deng-weihong/binbot/01_3D_MD_ME_Binbot/README.md

# BinBot 3D 与机械设计资料

**当前结构仅适用于 3D 打印，未做拔模设计，不可直接用于开模注塑。**

| 目录 | 内容 | 当前资料 |
| --- | --- | --- |
| [MD](MD/README.md) | 机械结构设计（Mechanical Design） | 结构总装、子装配、壳体、支架与垫片的 STEP 模型，共 23 个文件 |

机械结构资料的打开入口为
[`MD/step/binbot_master_asm_top.stp`](MD/step/binbot_master_asm_top.stp)。
请下载整个 `MD/step/` 目录，保留其中所有模型的原始文件名和相对位置。

PCB、原理图、BOM 和板级说明归入 [硬件资料目录](../03_Hardware_Binbot/)。
