deng-weihong/binbot/01_3D_MD_ME_Binbot/MD/step/camera_fix_prt.stp

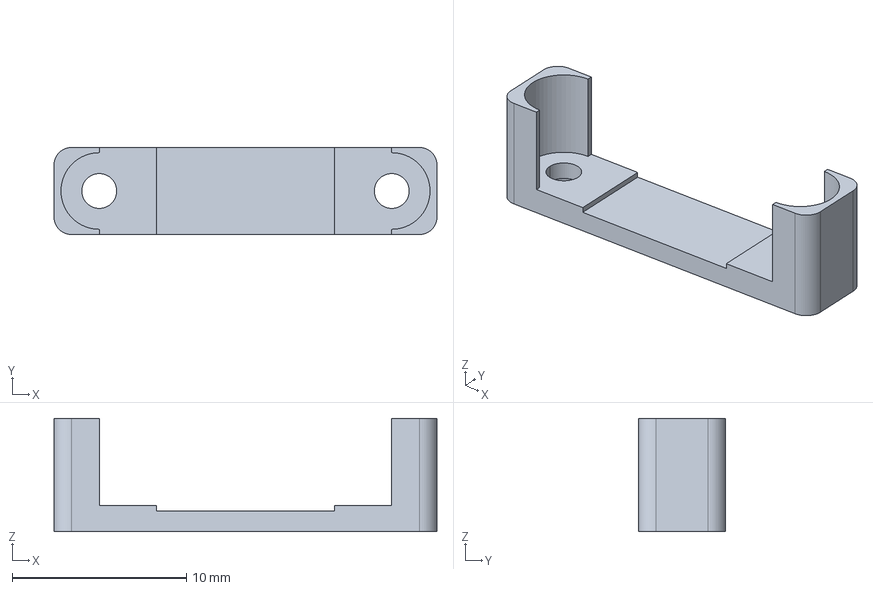
[picture p9: CAD file, 2026-11-06]
01_3D_MD_ME_Binbot/MD/step/camera_fix_prt.stp
22.0 x 5.00 x 6.50 mm
