deng-weihong/binbot/01_3D_MD_ME_Binbot/MD/step/speaker_shell_prt.stp

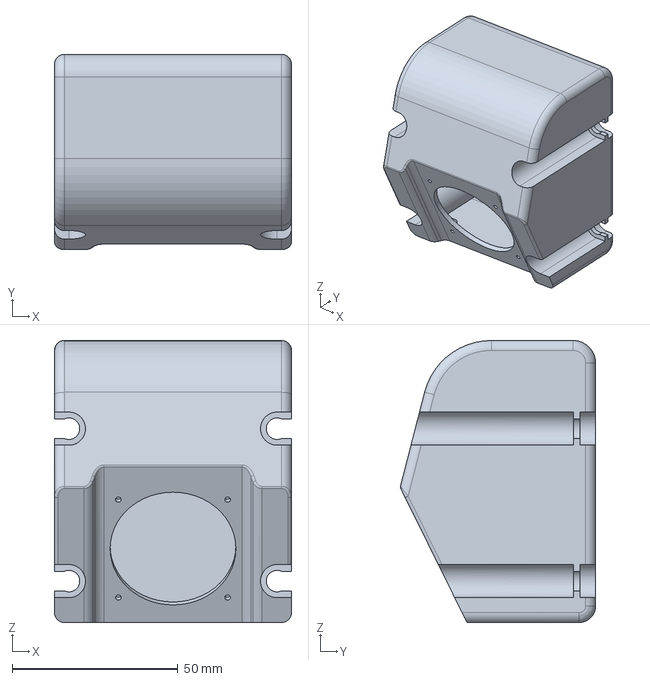
[picture p10: CAD file, 2026-11-06]
01_3D_MD_ME_Binbot/MD/step/speaker_shell_prt.stp
71.6 x 59.0 x 85.2 mm
