deng-weihong/binbot/01_3D_MD_ME_Binbot/MD/step/rubber_pad_44_12_2_prt.stp

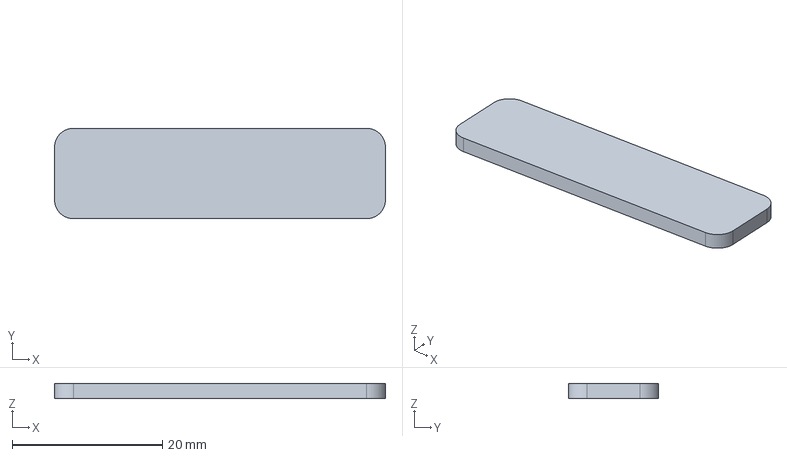
[picture p11: CAD file, 2026-11-06]
01_3D_MD_ME_Binbot/MD/step/rubber_pad_44_12_2_prt.stp
44.0 x 12.0 x 2.00 mm
