deng-weihong/binbot/01_3D_MD_ME_Binbot/MD/step/key_fix_prt.stp

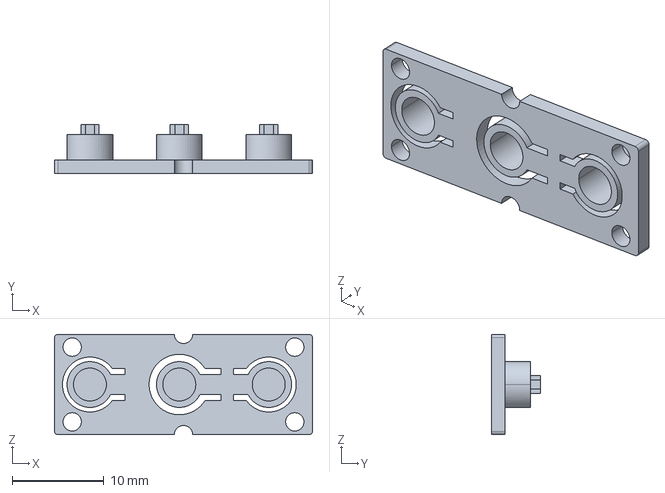
[picture p12: CAD file, 2026-11-06]
01_3D_MD_ME_Binbot/MD/step/key_fix_prt.stp
28.2 x 5.40 x 11.0 mm
