deng-weihong/binbot/01_3D_MD_ME_Binbot/MD/step/rear_cover_prt.stp

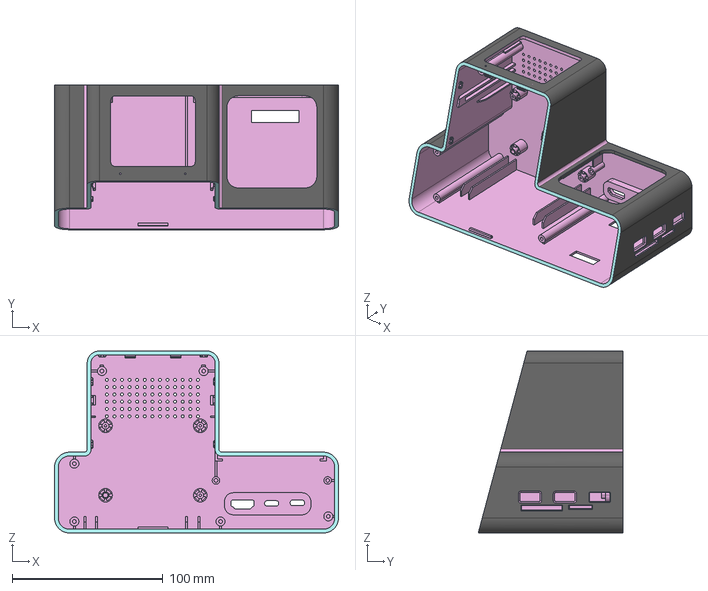
[picture p13: CAD file, 2026-11-06]
01_3D_MD_ME_Binbot/MD/step/rear_cover_prt.stp
188.4 x 95.9 x 120.7 mm
