deng-weihong/binbot/01_3D_MD_ME_Binbot/MD/step/front_ctrl_key_small__prt.stp

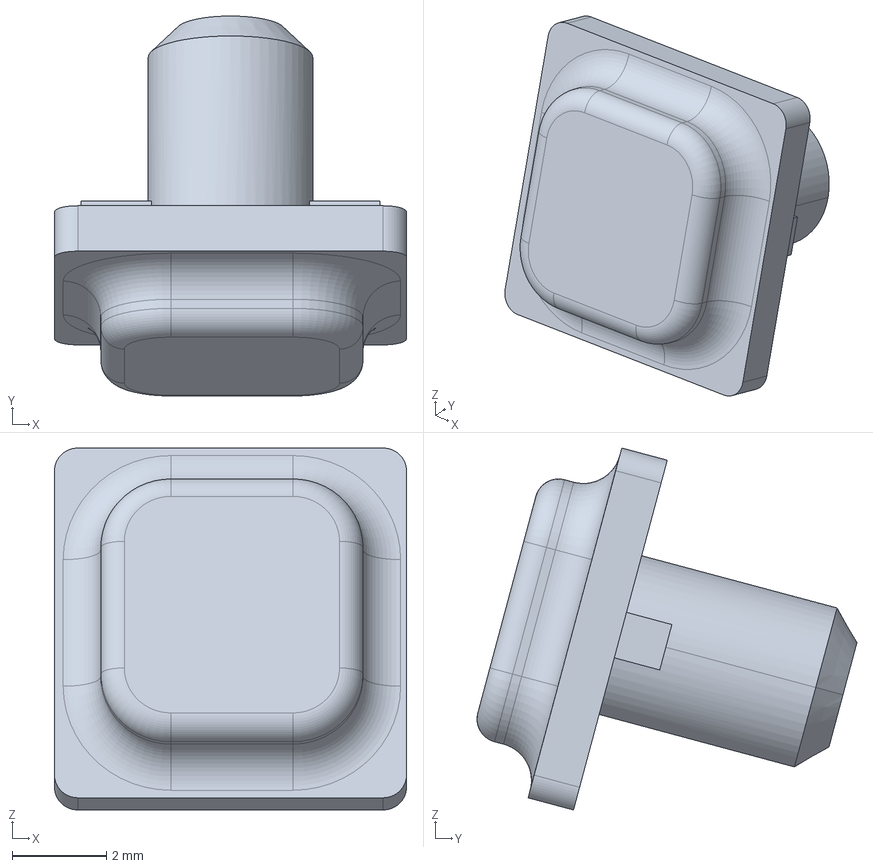
[picture p14: CAD file, 2026-11-06]
01_3D_MD_ME_Binbot/MD/step/front_ctrl_key_small__prt.stp
7.48 x 8.08 x 7.70 mm
