deng-weihong/binbot/01_3D_MD_ME_Binbot/MD/step/front_ctrl_board_part__prt.stp

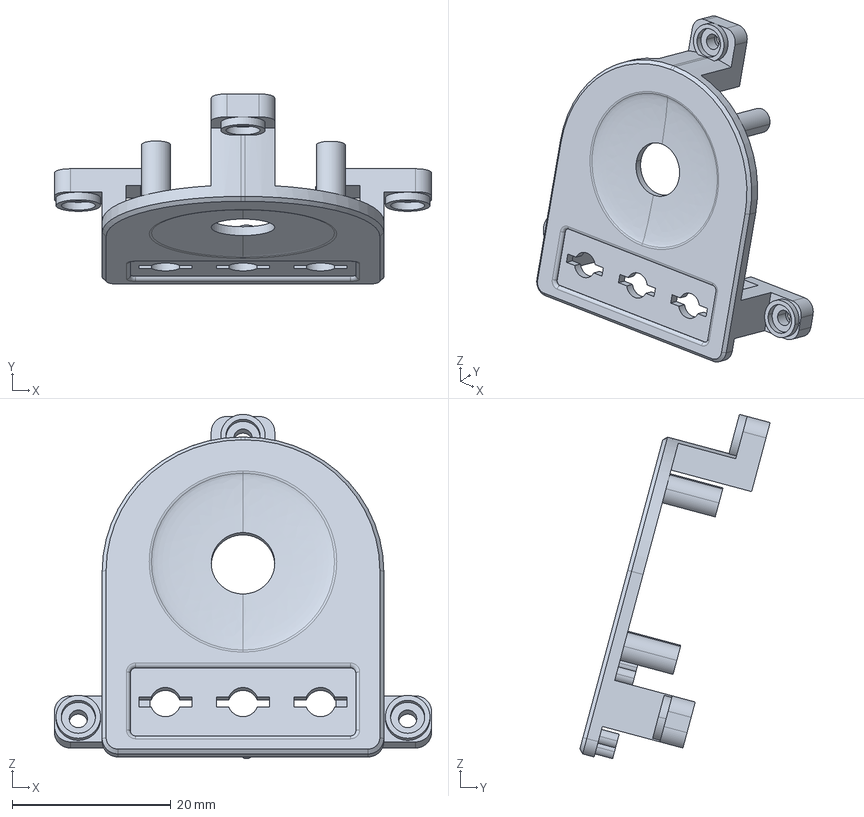
[picture p15: CAD file, 2026-11-06]
01_3D_MD_ME_Binbot/MD/step/front_ctrl_board_part__prt.stp
47.5 x 24.0 x 43.3 mm
