deng-weihong/binbot/01_3D_MD_ME_Binbot/MD/step/front_ctrl_knob__prt.stp

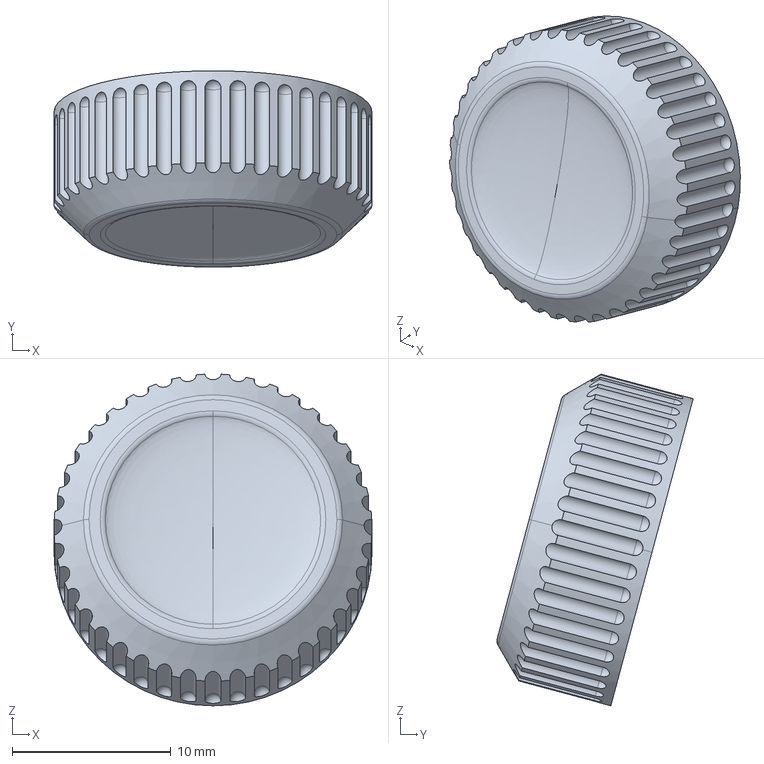
[picture p16: CAD file, 2026-11-06]
01_3D_MD_ME_Binbot/MD/step/front_ctrl_knob__prt.stp
20.0 x 12.3 x 20.9 mm
