deng-weihong/binbot/01_3D_MD_ME_Binbot/MD/step/module_slot_prt.stp

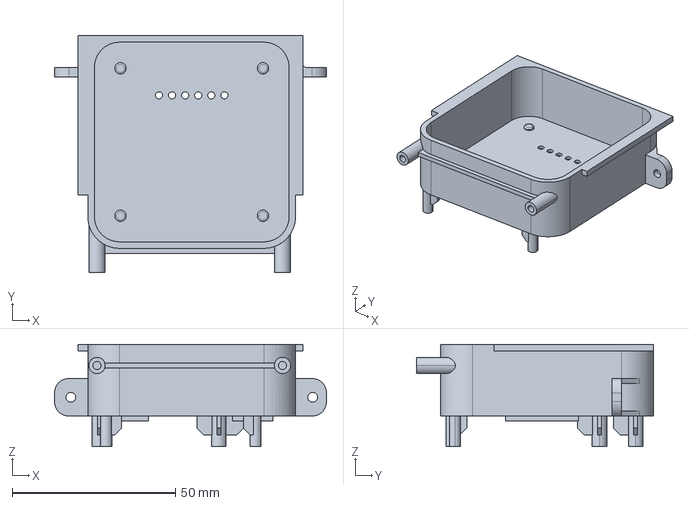
[picture p17: CAD file, 2026-11-06]
01_3D_MD_ME_Binbot/MD/step/module_slot_prt.stp
83.4 x 72.5 x 31.4 mm
