deng-weihong/binbot/01_3D_MD_ME_Binbot/MD/step/acoutsti_cover_prt.stp

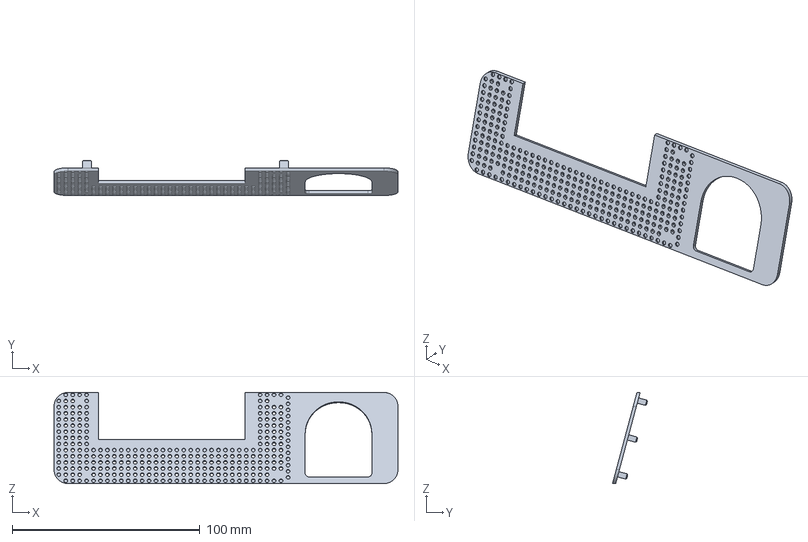
[picture p18: CAD file, 2026-11-06]
01_3D_MD_ME_Binbot/MD/step/acoutsti_cover_prt.stp
183.3 x 18.6 x 48.5 mm
