deng-weihong/binbot/01_3D_MD_ME_Binbot/MD/step/top_wireless_charge_prt.stp

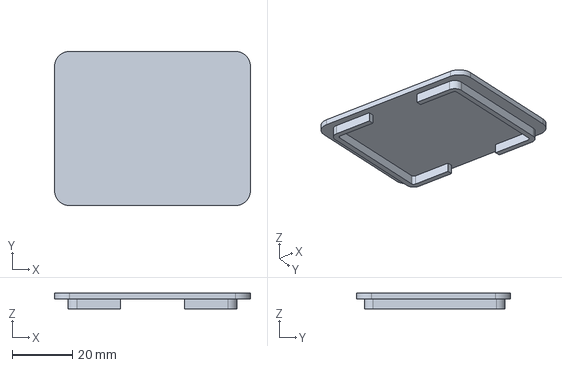
[picture p19: CAD file, 2026-11-06]
01_3D_MD_ME_Binbot/MD/step/top_wireless_charge_prt.stp
65.0 x 51.2 x 5.30 mm
