deng-weihong/binbot/01_3D_MD_ME_Binbot/MD/step/wireless_charge_pcba_fix_prt.stp

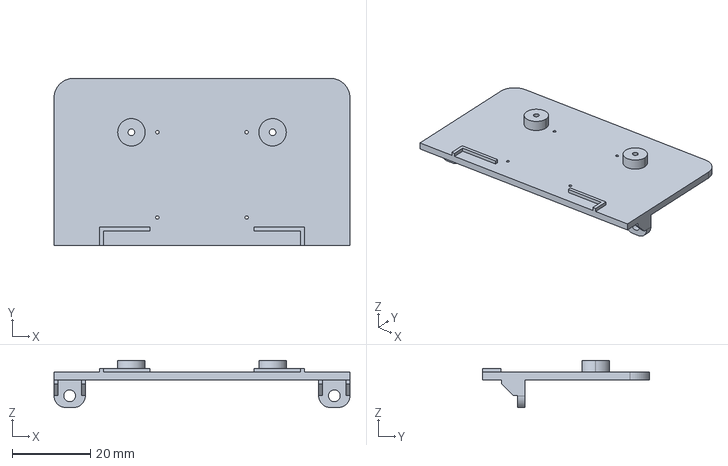
[picture p20: CAD file, 2026-11-06]
01_3D_MD_ME_Binbot/MD/step/wireless_charge_pcba_fix_prt.stp
75.5 x 42.7 x 12.0 mm
