deng-weihong/binbot/01_3D_MD_ME_Binbot/MD/step/acousti_fix_cover_prt.stp

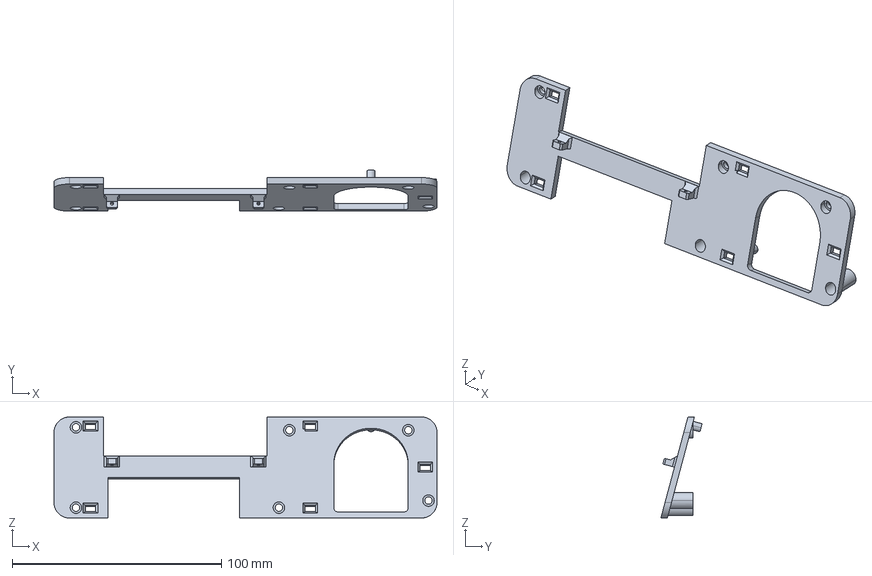
[picture p21: CAD file, 2026-11-06]
01_3D_MD_ME_Binbot/MD/step/acousti_fix_cover_prt.stp
183.0 x 19.7 x 48.2 mm
