deng-weihong/binbot/01_3D_MD_ME_Binbot/MD/step/front_cover_prt.stp

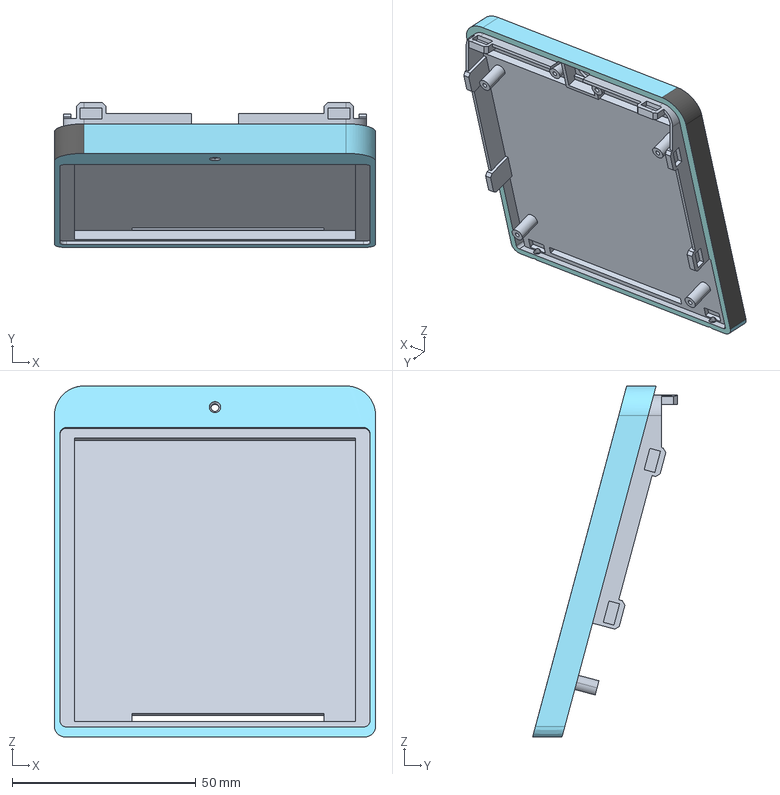
[picture p22: CAD file, 2026-11-06]
01_3D_MD_ME_Binbot/MD/step/front_cover_prt.stp
87.4 x 39.4 x 95.5 mm
