deng-weihong/binbot/01_3D_MD_ME_Binbot/MD/step/wireless_charge_coil_fix_prt.stp

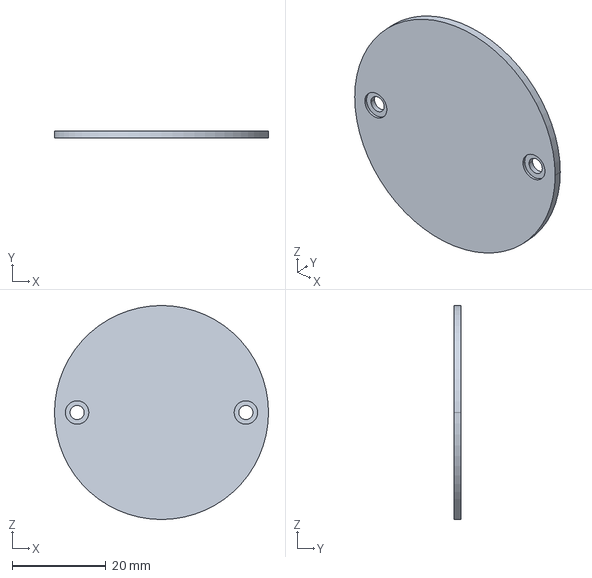
[picture p23: CAD file, 2026-11-06]
01_3D_MD_ME_Binbot/MD/step/wireless_charge_coil_fix_prt.stp
45.6 x 1.50 x 45.6 mm
