deng-weihong/binbot/01_3D_MD_ME_Binbot/MD/step/front_ctrl_key_big__prt.stp

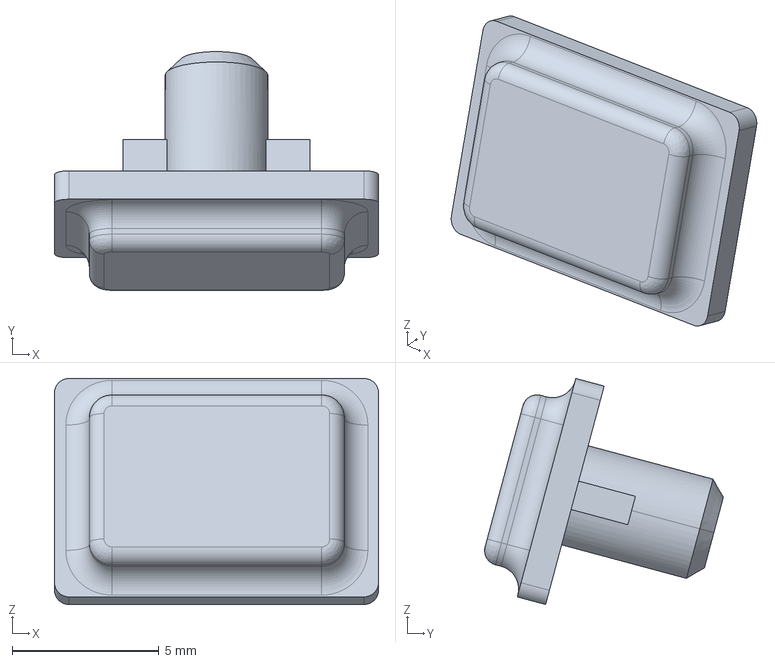
[picture p24: CAD file, 2026-11-06]
01_3D_MD_ME_Binbot/MD/step/front_ctrl_key_big__prt.stp
11.0 x 8.13 x 7.70 mm
