deng-weihong/binbot/(list of files, cad)

Other CAD files:
01_3D_MD_ME_Binbot/MD/step/binbot_shell_asm_asm.stp
01_3D_MD_ME_Binbot/MD/step/binbot_master_asm_top.stp
01_3D_MD_ME_Binbot/MD/step/speaker_asm_asm.stp
01_3D_MD_ME_Binbot/MD/step/speaker_unit_asm_asm.stp
01_3D_MD_ME_Binbot/MD/step/binbot_ee_system_asm.stp
01_3D_MD_ME_Binbot/MD/step/soundhole_shell_as_asm.stp
01_3D_MD_ME_Binbot/MD/step/rubber_mat_prt.stp
