deng-weihong/binbot/03_Hardware_Binbot/RV1106G3_Main_Release_V1.0.pdf

# Index：

# P01 VERSION HISTORY

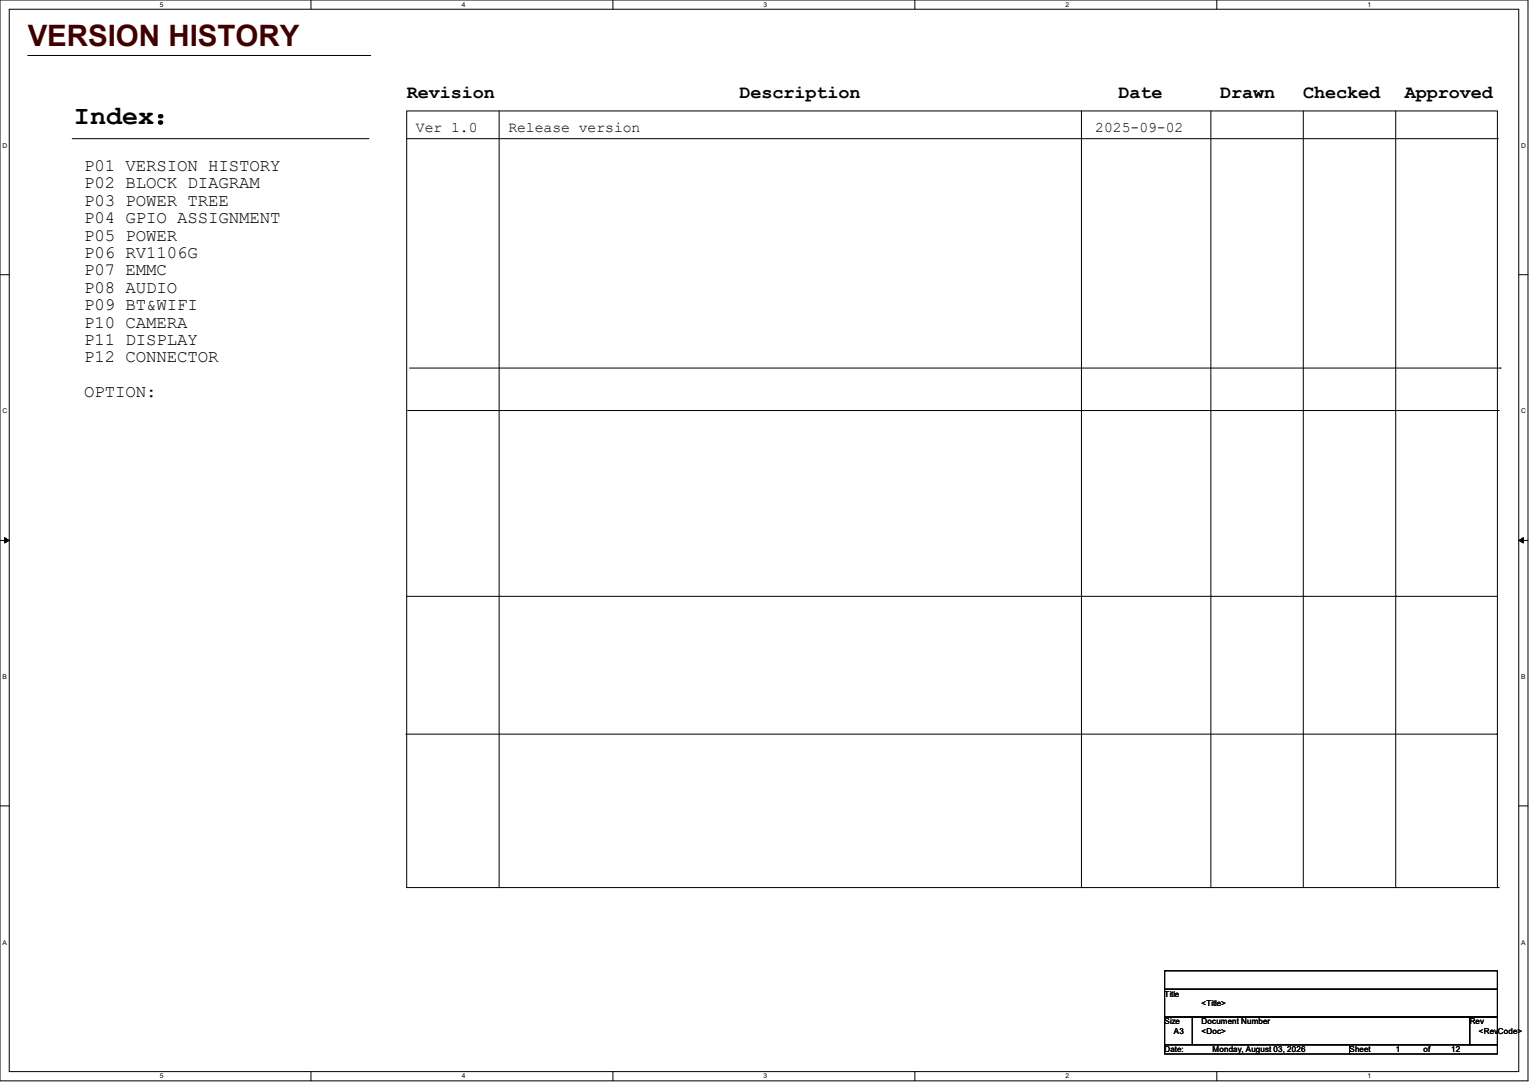
[picture p25: page 1]

# BLOCK

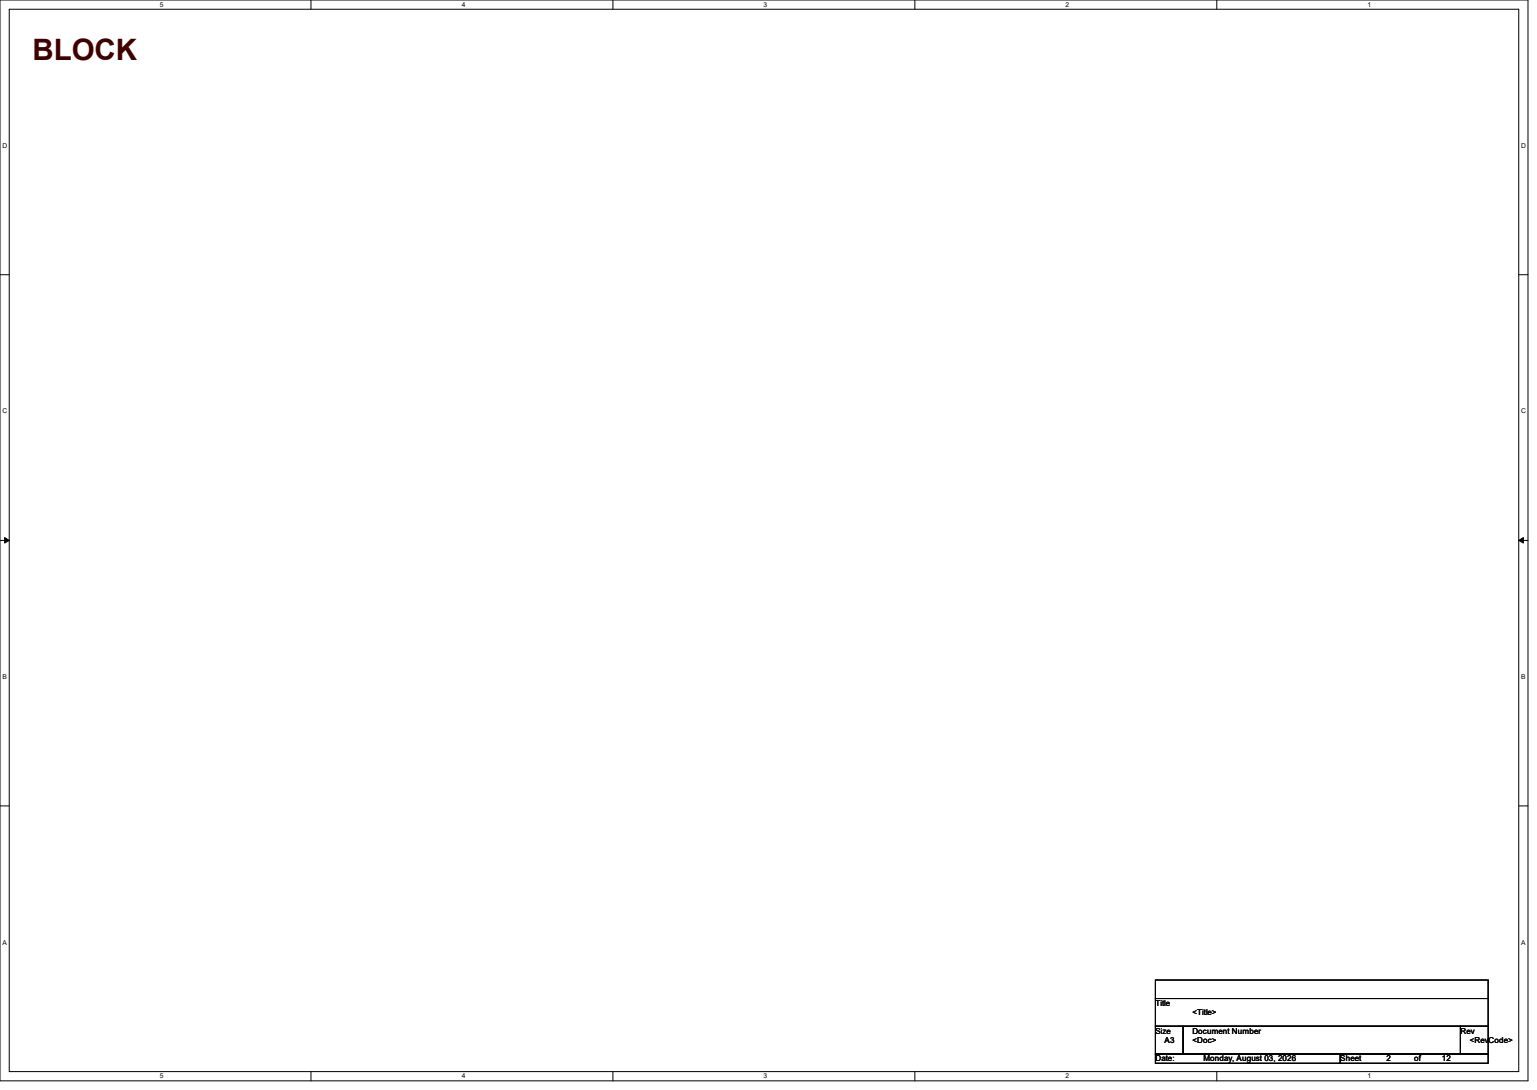
[picture p26: page 2]
Title; Monday, August 03, 2026

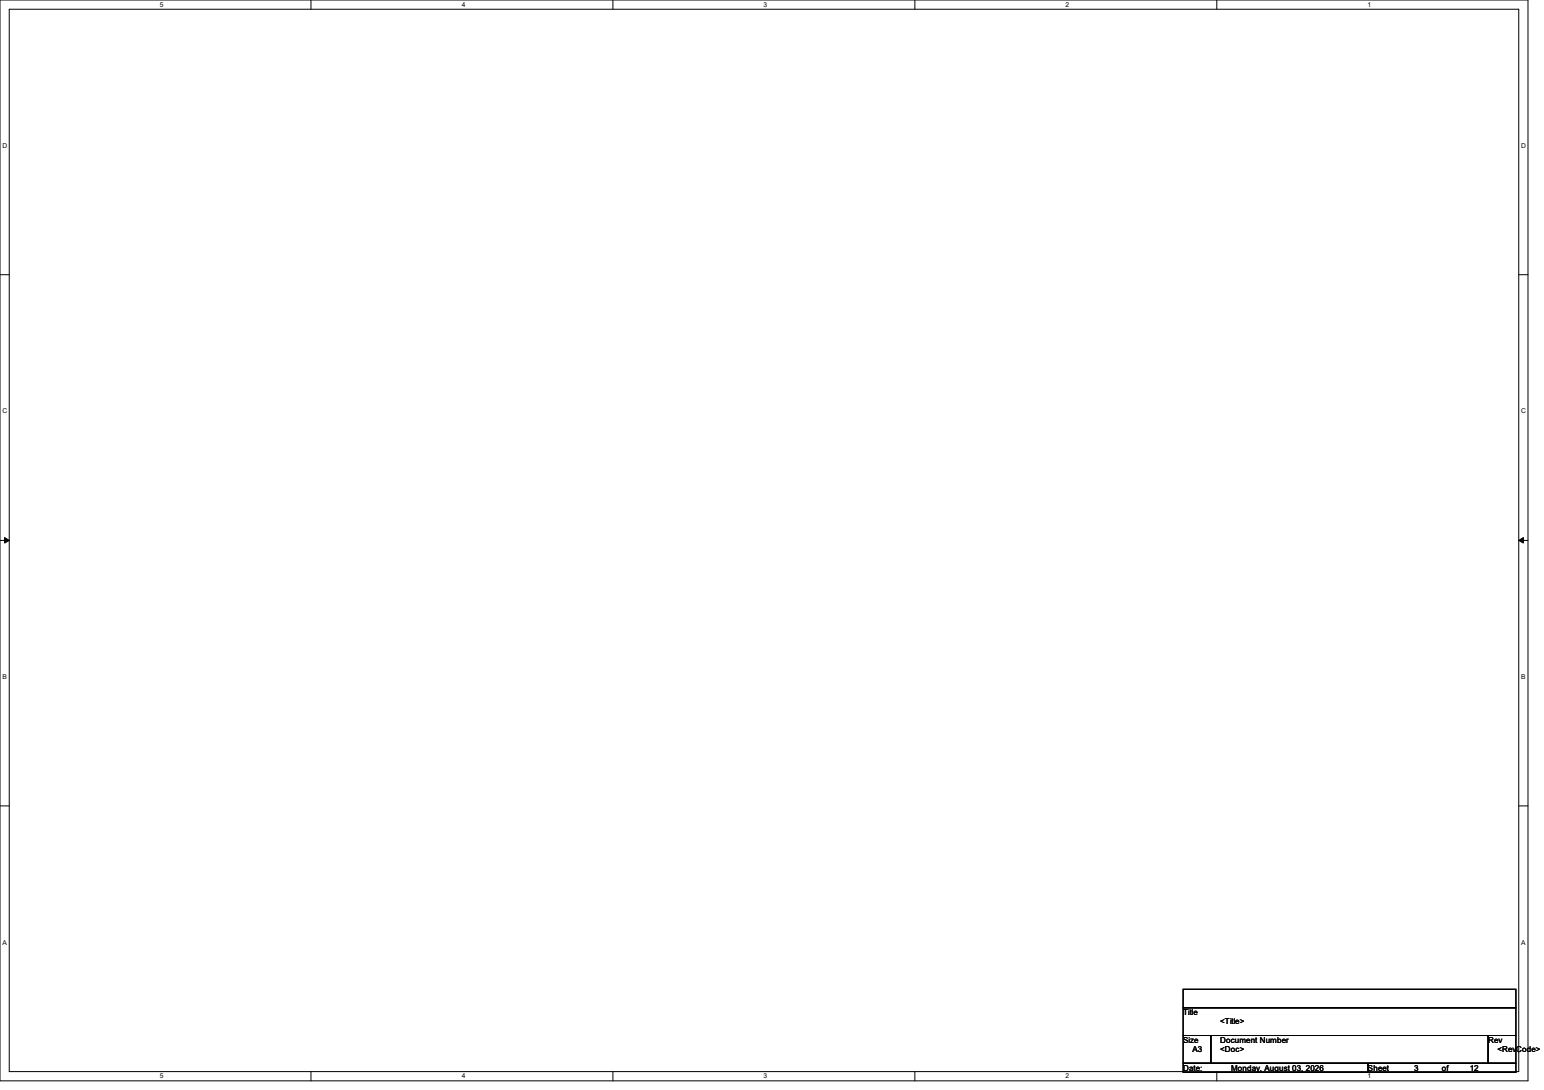
[picture p27: page 3]
Monday, August 03, 2026

# GPIO ASSIGNMENT

PIN | Define | CFG | Function

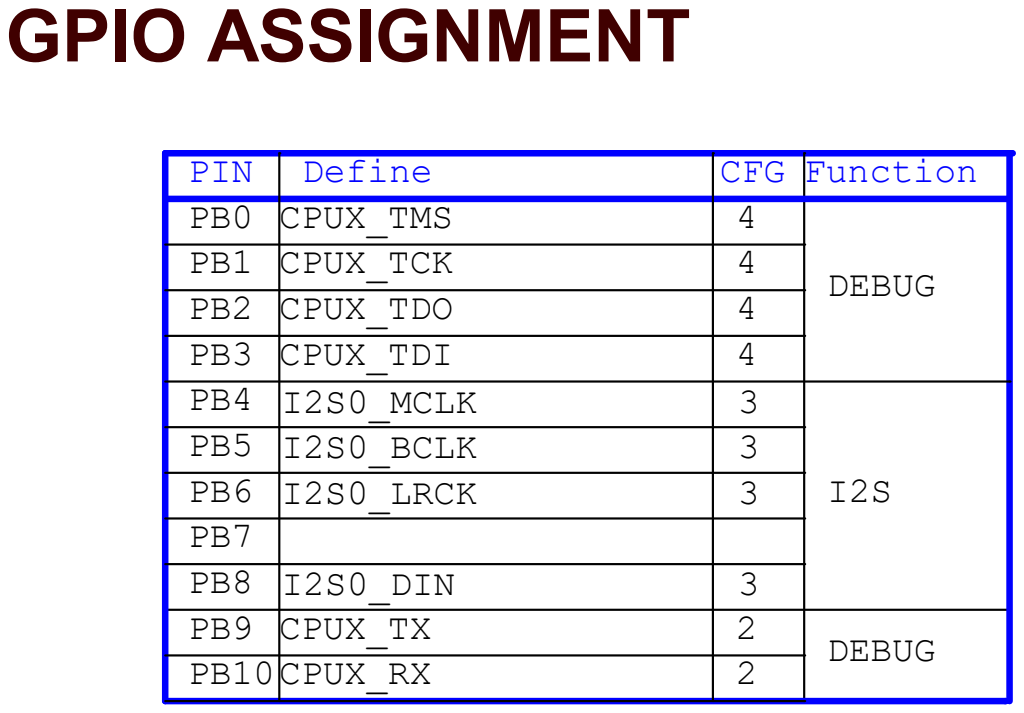
[picture p28: page 4]
DEBUG; CPUX_RX; CPUX_TX; Monday, August 03, 2026

PB0 | CPUX_TMS | 4 | DEBUG
PB1 | CPUX_TCK | 4
PB2 | CPUX_TDO | 4
PB3 | CPUX_TDI | 4
PB4 | I2S0_MCLK | 3 | I2S
PB5 | I2S0_BCLK | 3
PB6 | I2S0_LRCK | 3
PB7
PB8 | I2S0_DIN | 3

VCC-1V8 | VCC-OSC
VCC-3V3 | VCC-RTC

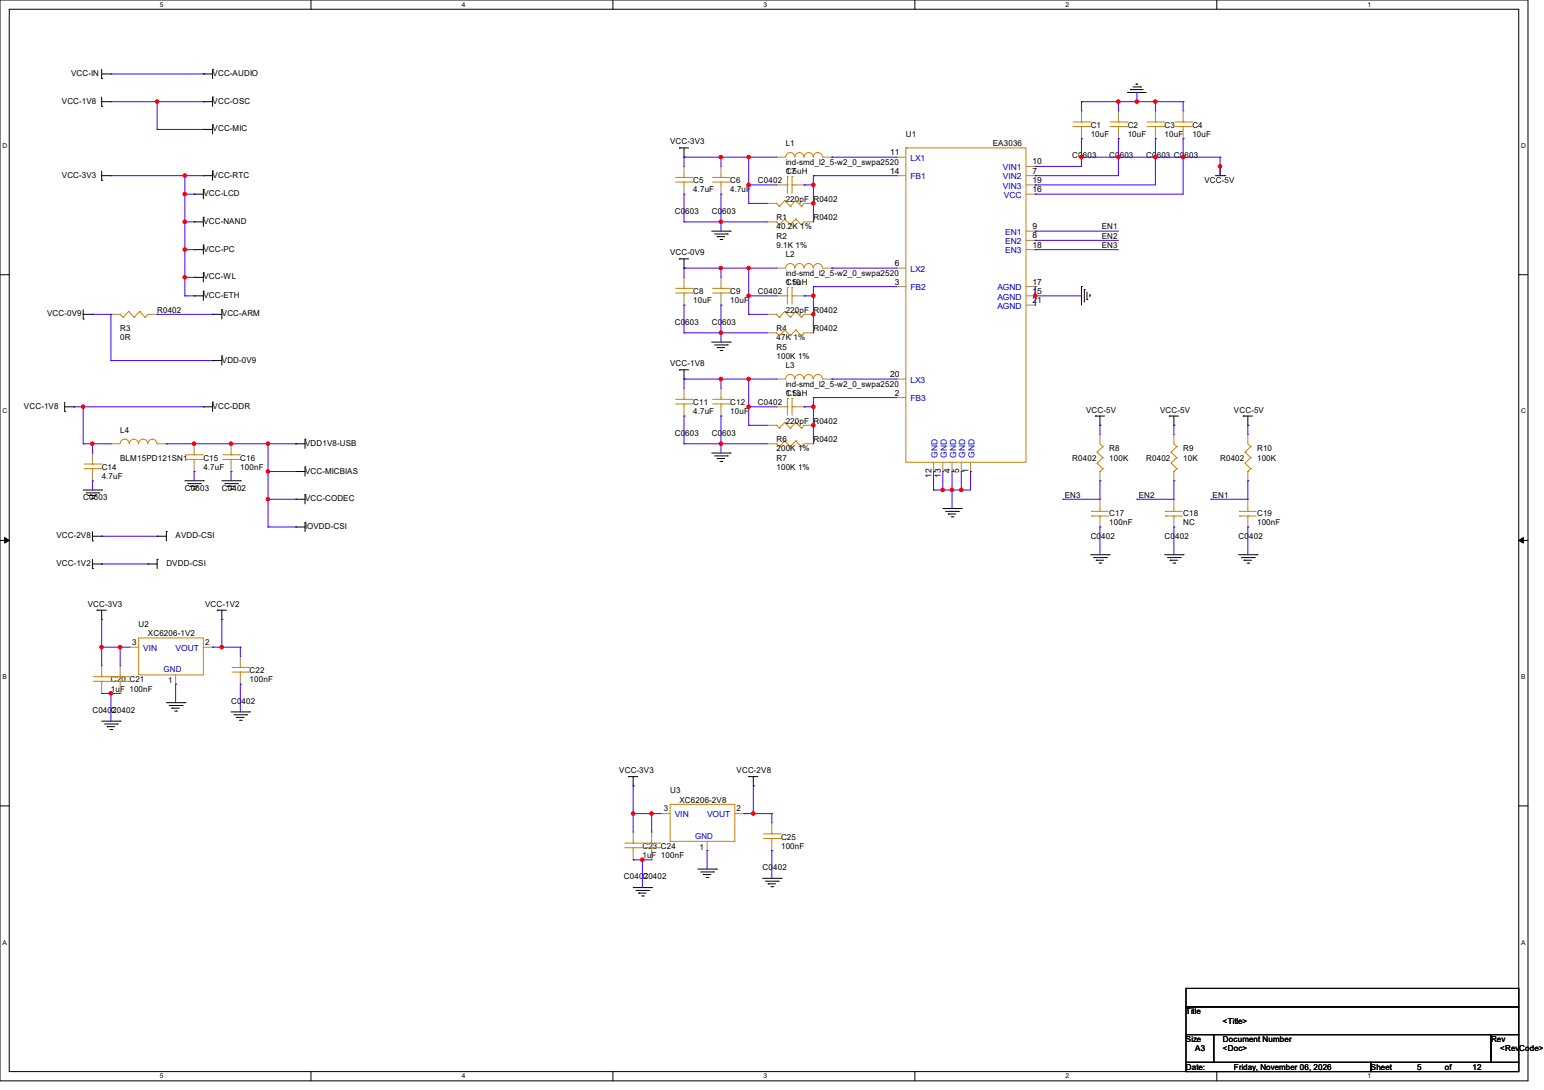
[picture p29: page 5]

# OSC/PLL/OTP

# RTC

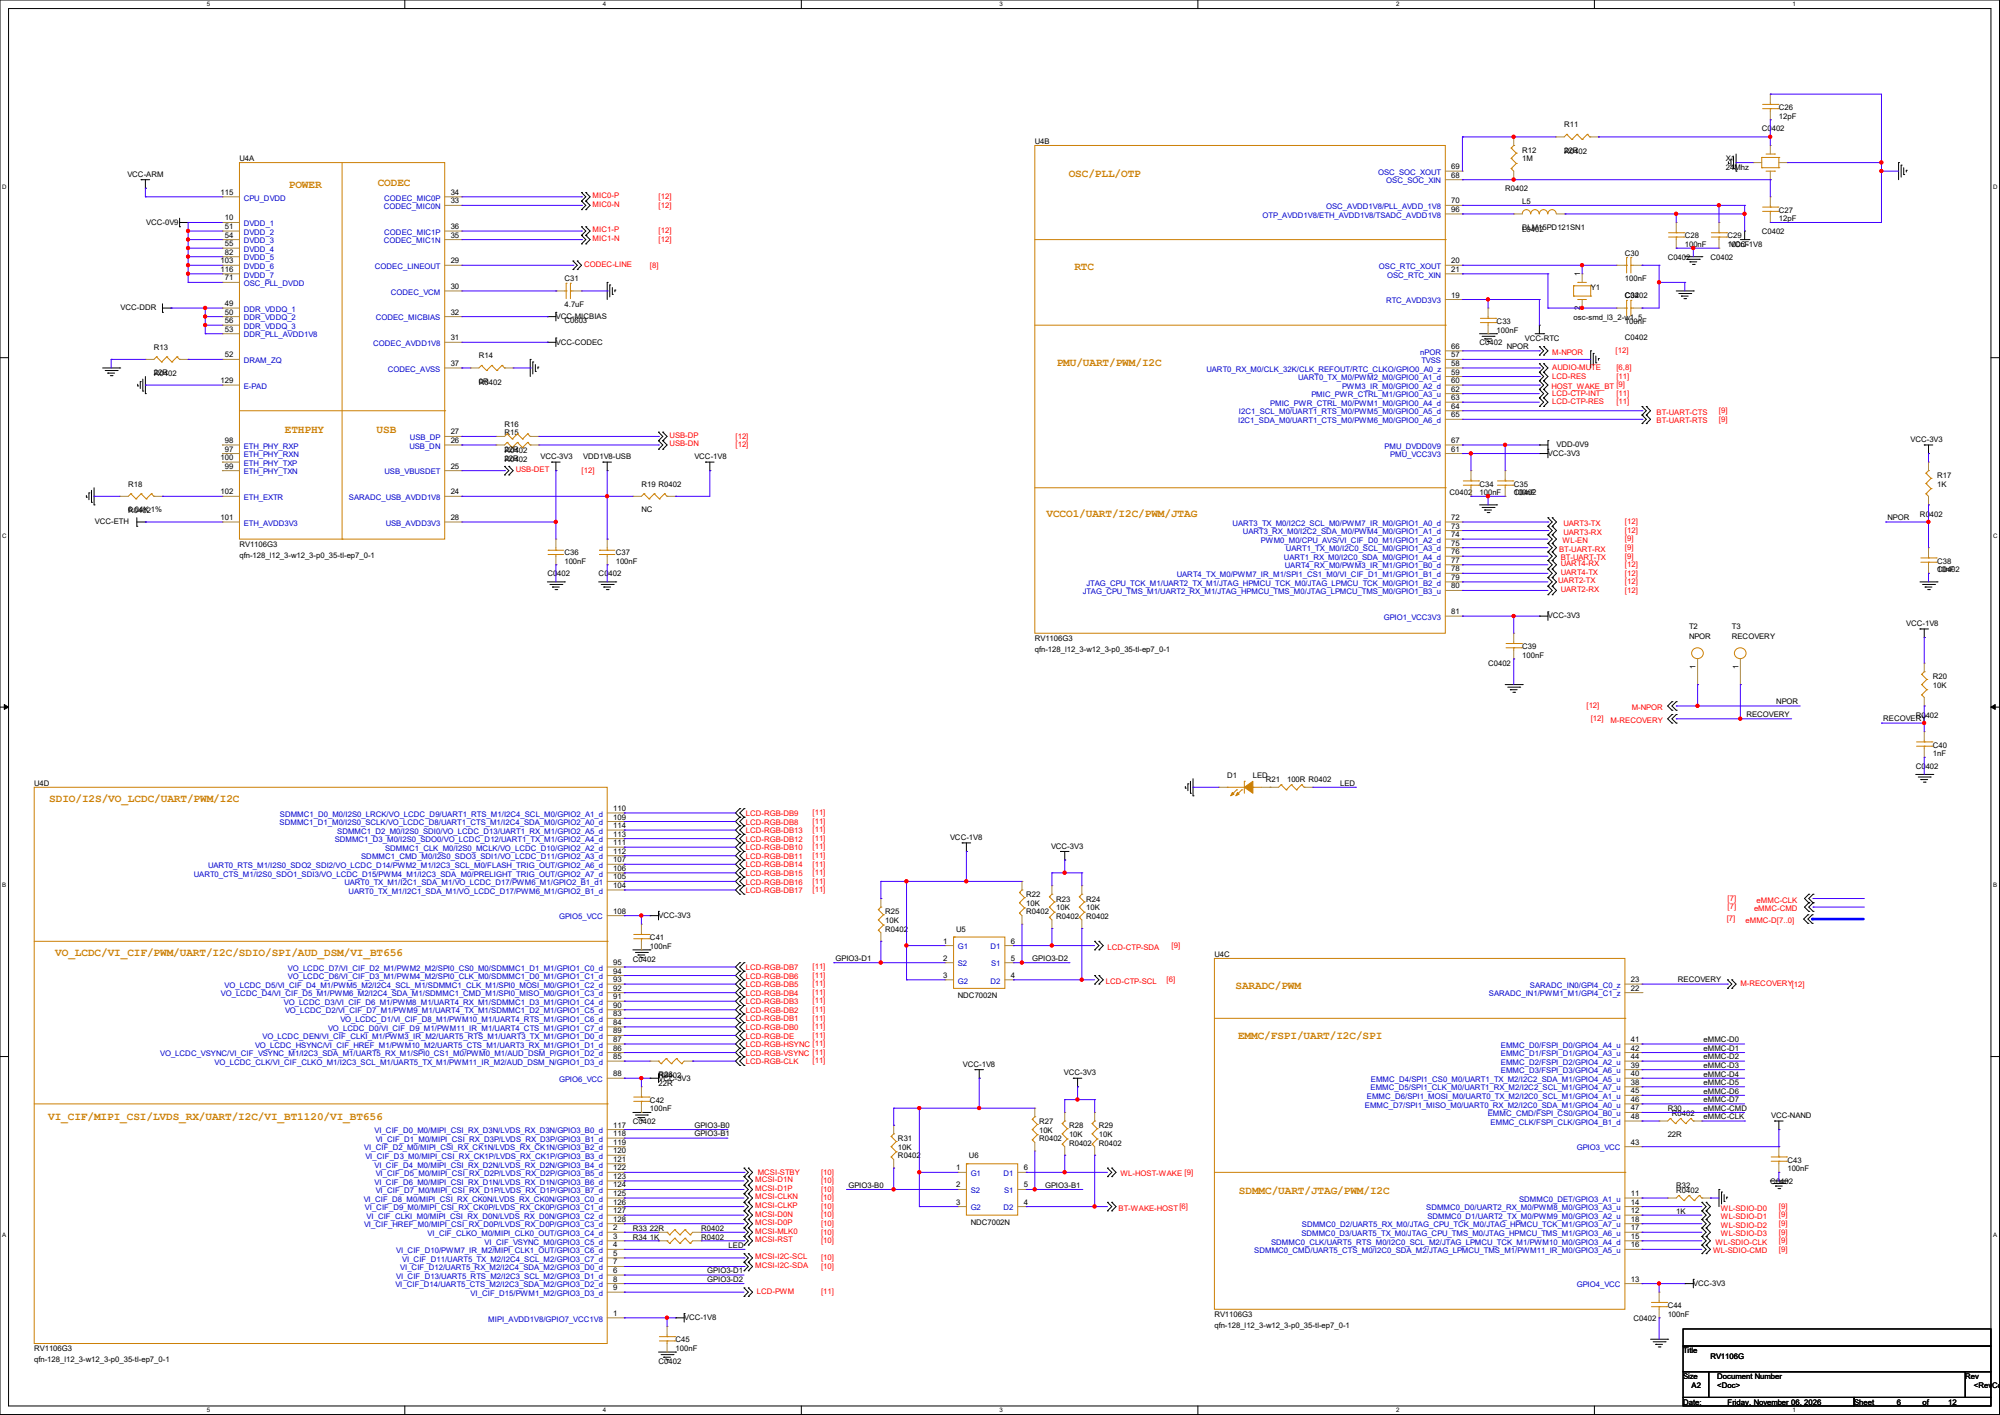
[picture p30: page 6]

VO_LCDC/VI_CIF/PWM/UART/I2C/SDIO/SPI/AUD_DSM/VI_BT656

EMMC/FSPI/UART/I2C/SPI

NDC7002N | 47 R30 eMMC-CMD 48 eMMC-CLK

SDMMC/UART/JTAG/PWM/I2C

E

M

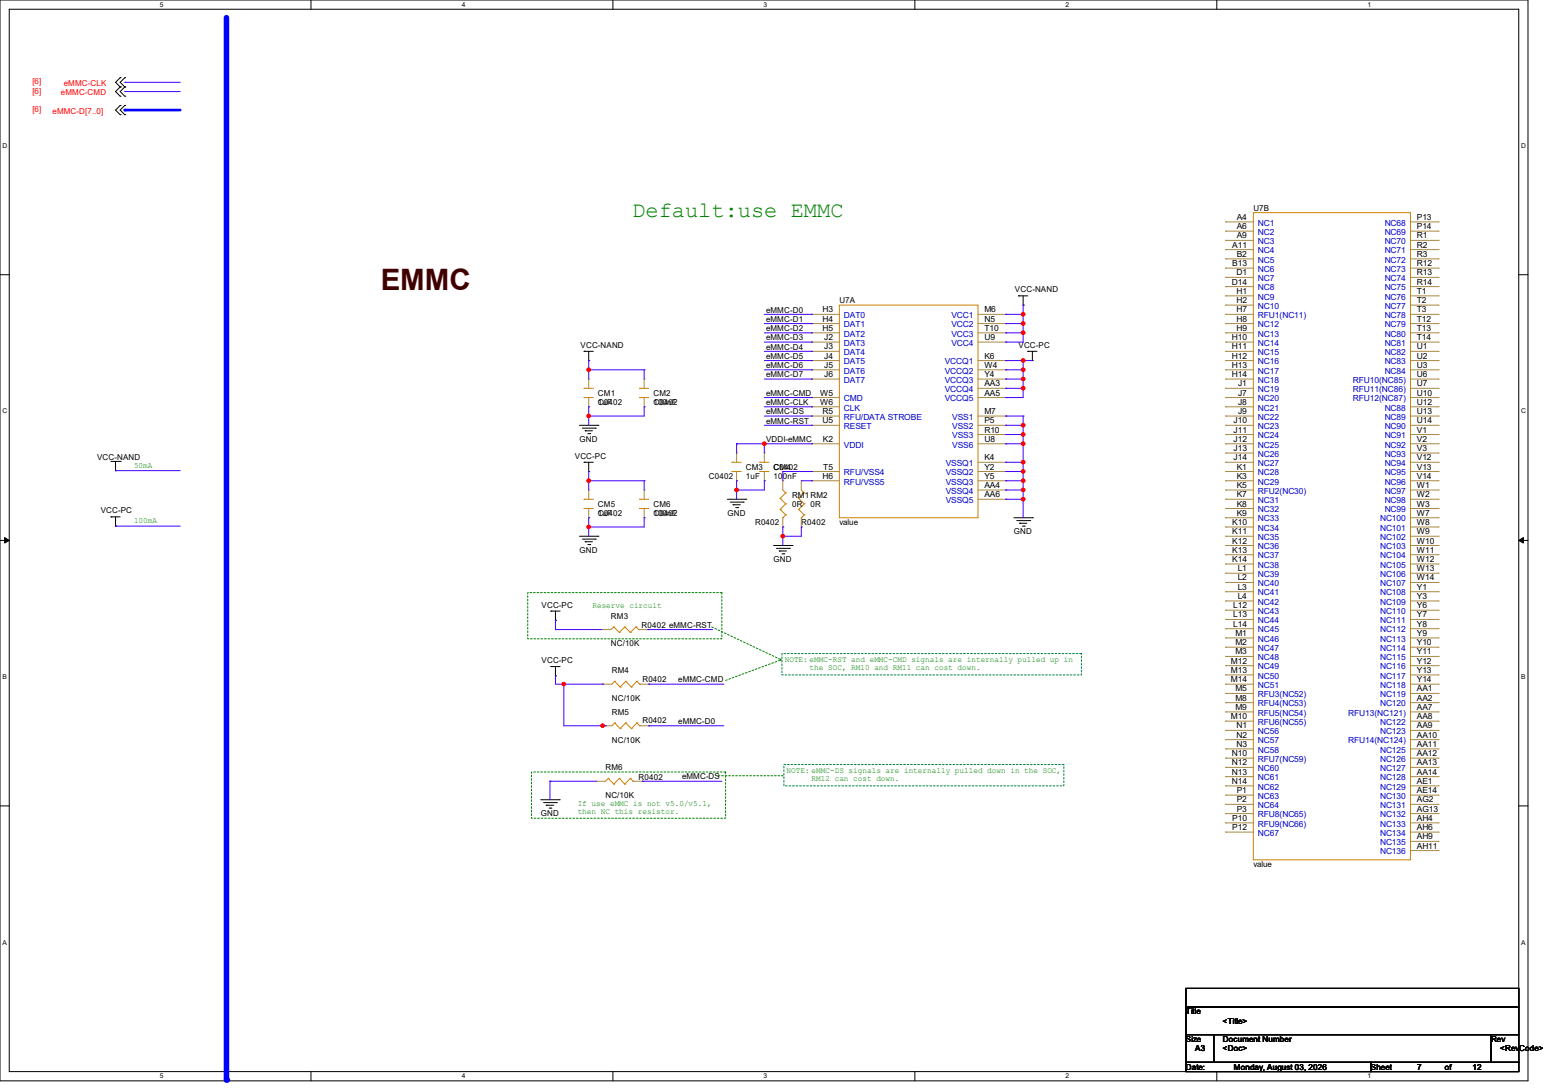
[picture p31: page 7]
Title Size; alu

D | D

# [6] CODEC-LINE

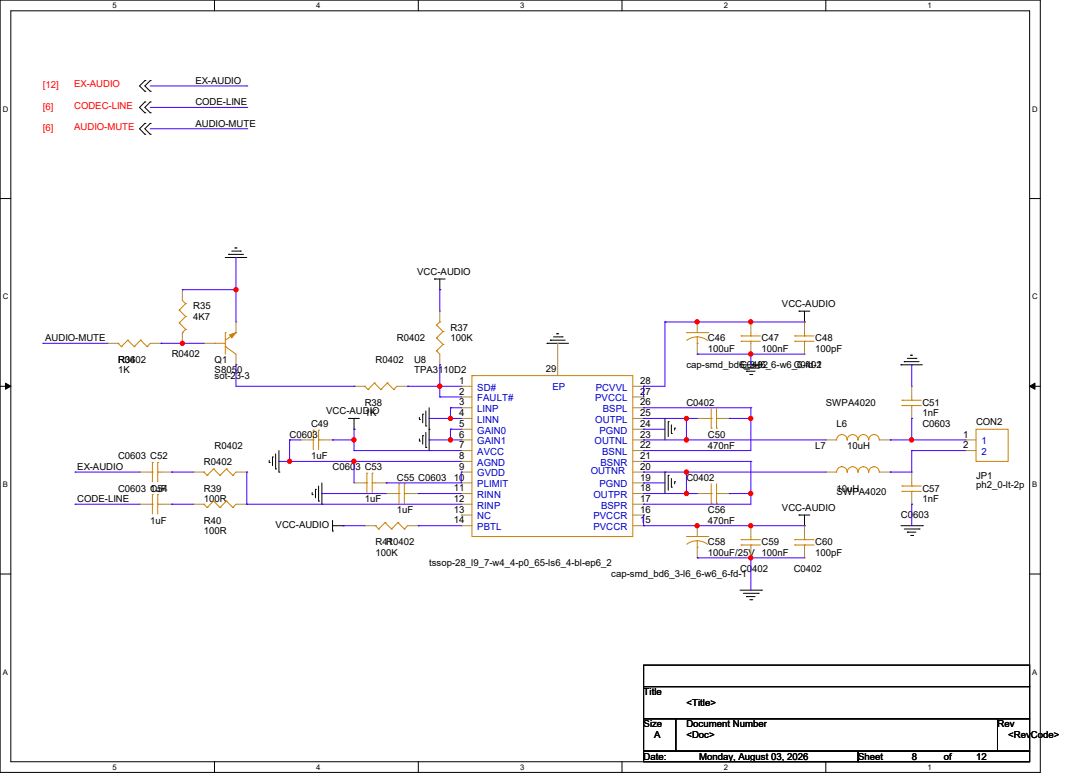
[picture p32: page 8]

55

44

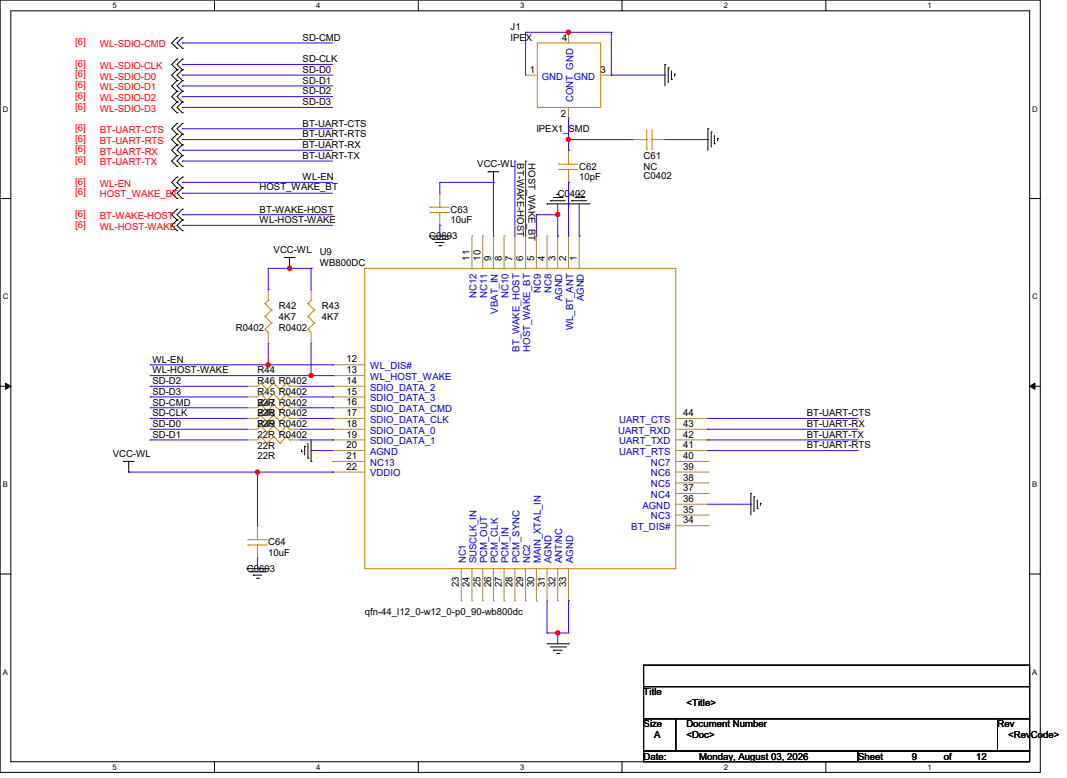
[picture p33: page 9]
DIO; Title Size; Title; GND 4 CONT 2; cBT_WAKE_HOST 7; DIS; HOST_WAKE_BT 6; AGND 1; AGND 3; AGND 31; AGND 33; ANT/NC 32; SUSCLK_IN 24; PCM_CLK 26 PCM_IN 27; PCM_OUT 25; PCM_SYNC 28; MAIN_XTAL_IN 30; VBAT_IN 9; WL_BT_ANT 2; HOST_WAKE_BT

BT-WAKE-HOST

D | D

# [6] MCSI-D1N

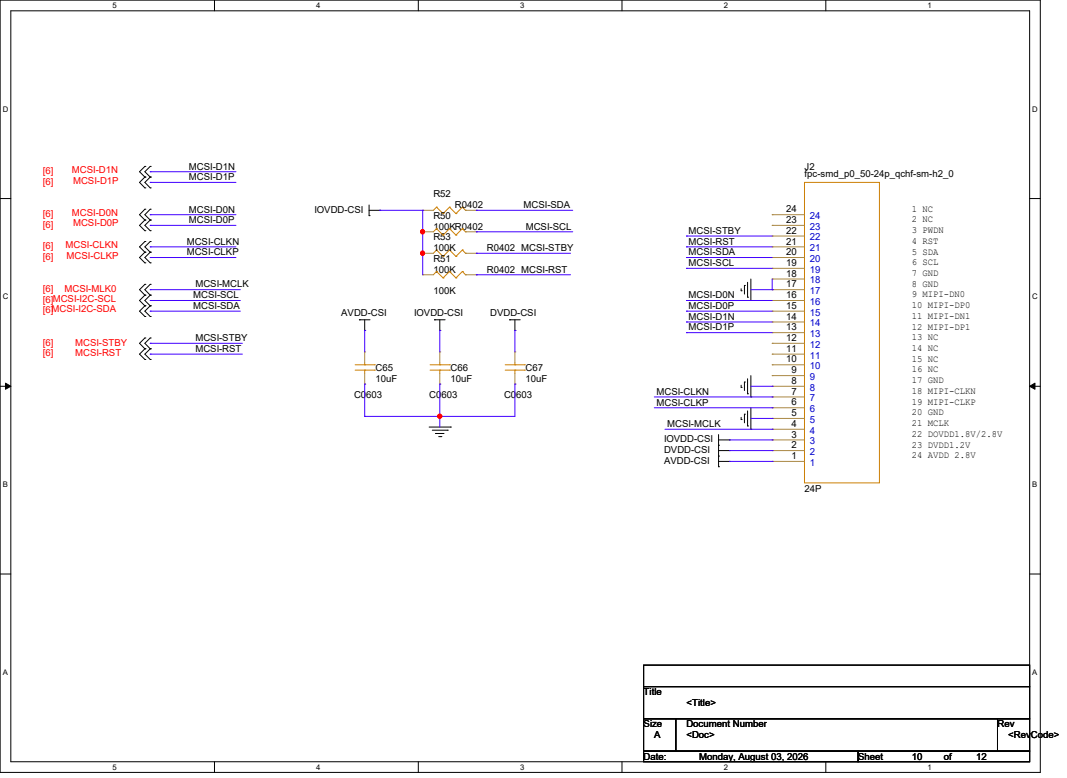
[picture p34: page 10]

V

C

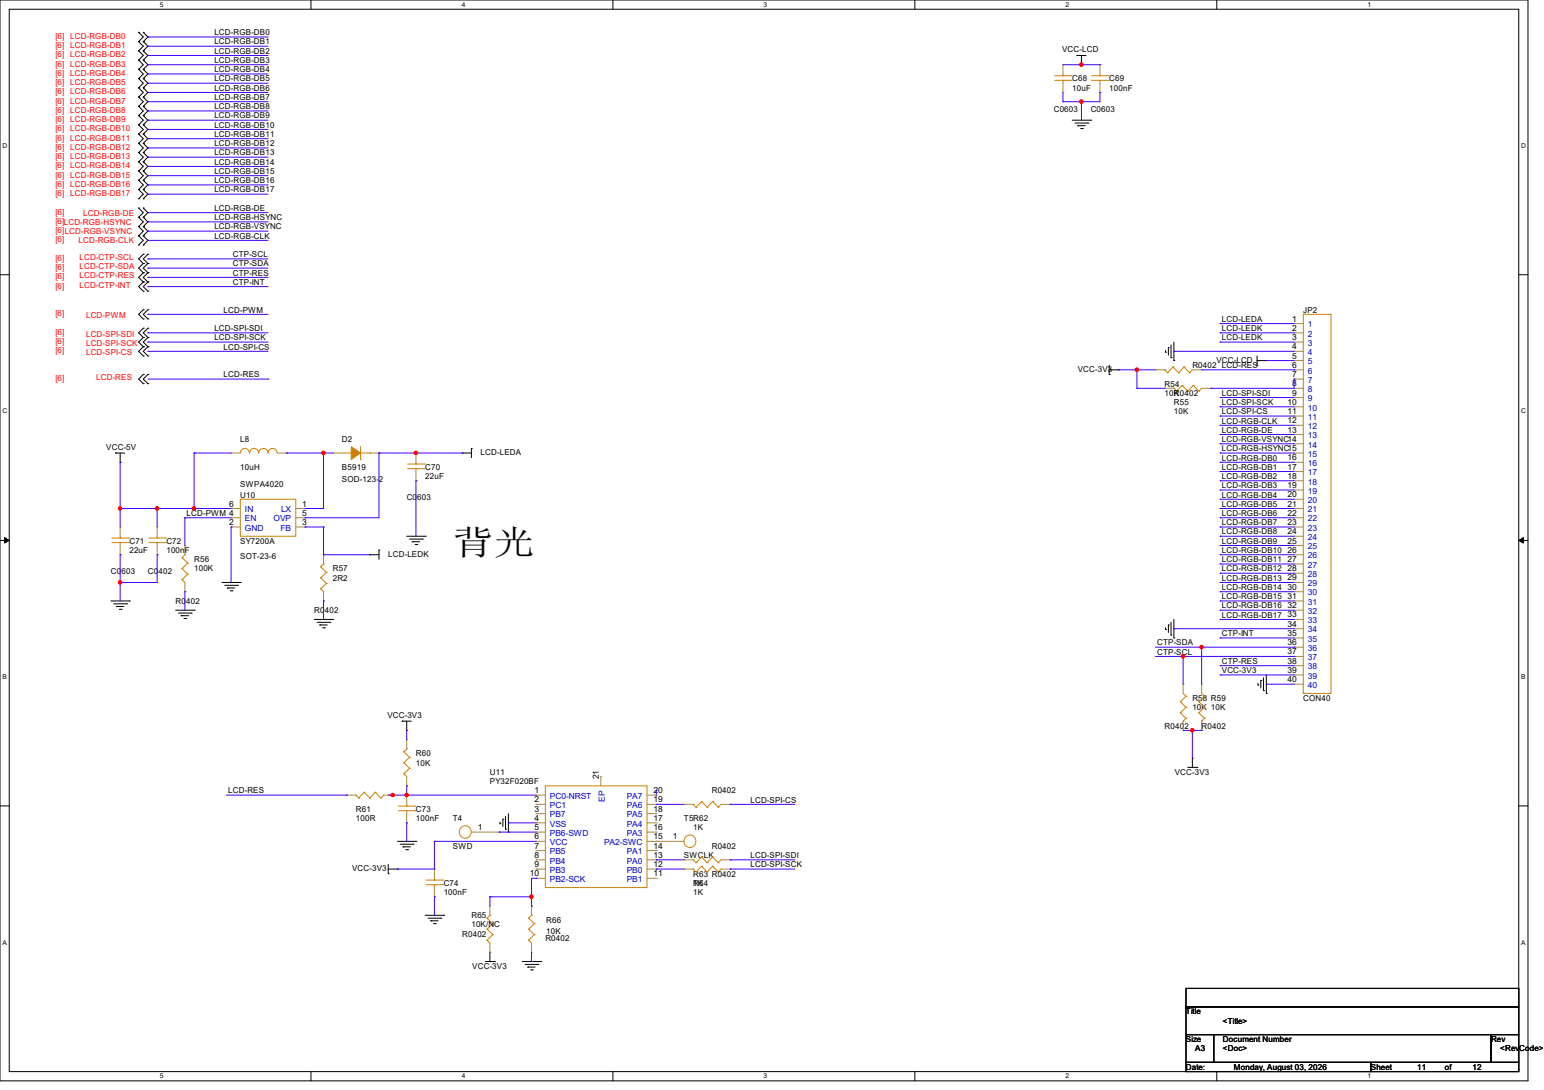
[picture p35: page 11]
LCD-SPI-SCK [6]; LCD-SPI-CS [6] LCD-RGB-DB0 [6] LCD-RGB-DB1 [6] LCD-RGB-DB2 [6] LCD-RGB-DB3 [6] LCD-RGB-DB4 [6] LCD-RGB-DB5 [6] LCD-RGB-DB6 [6] LCD-RGB-DB7 [6] LCD-RGB-DB8 [6] LCD-RGB-DB9 [6] LCD-RGB-DB10 [6] LCD-RGB-DB11 [6] LCD-RGB-DB12 [6] LCD-RGB-DB13 [6] LCD-RGB-DB14 [6] LCD-RGB-DB15 [6] LCD-RGB-DB16 [6] LCD-RGB-DB17 [6]; LCD-CTP-RES [6]; LCD-CTP-INT [6]; LCD-RES; Title Size; DI LCD-SPI-SCK LCD-SPI-CS LCD-RGB-DB1

DI LCD-SPI-SCK LCD-SPI-CS LCD-RGB-DE LCD-RGB-VSY

DI LCD-SPI-CS LCD-SPI-SCK

55

44

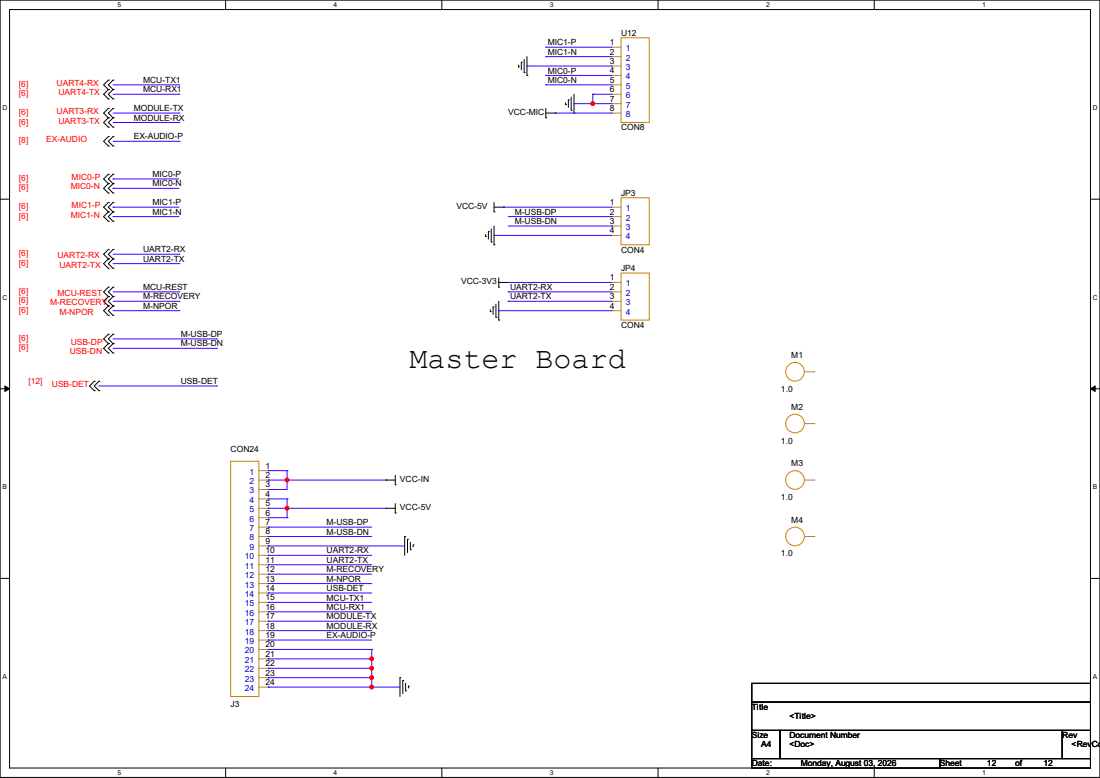
[picture p36: page 12]
MIC; DIO; Title Size
