deng-weihong/binbot/(commit log)

2026-11-06 整理结构模型、原理图与固件使用说明
2026-11-06 补充结构仅适用于3D打印及未做拔模设计的说明
2026-11-14 补充立创开源平台发布计划及维护说明
